Dirte420/zigbee-baseboard/plan/zigbee-baseboard.kicad_pcb

## KiCad design plan/zigbee-baseboard.kicad_pcb (2026-09-25)

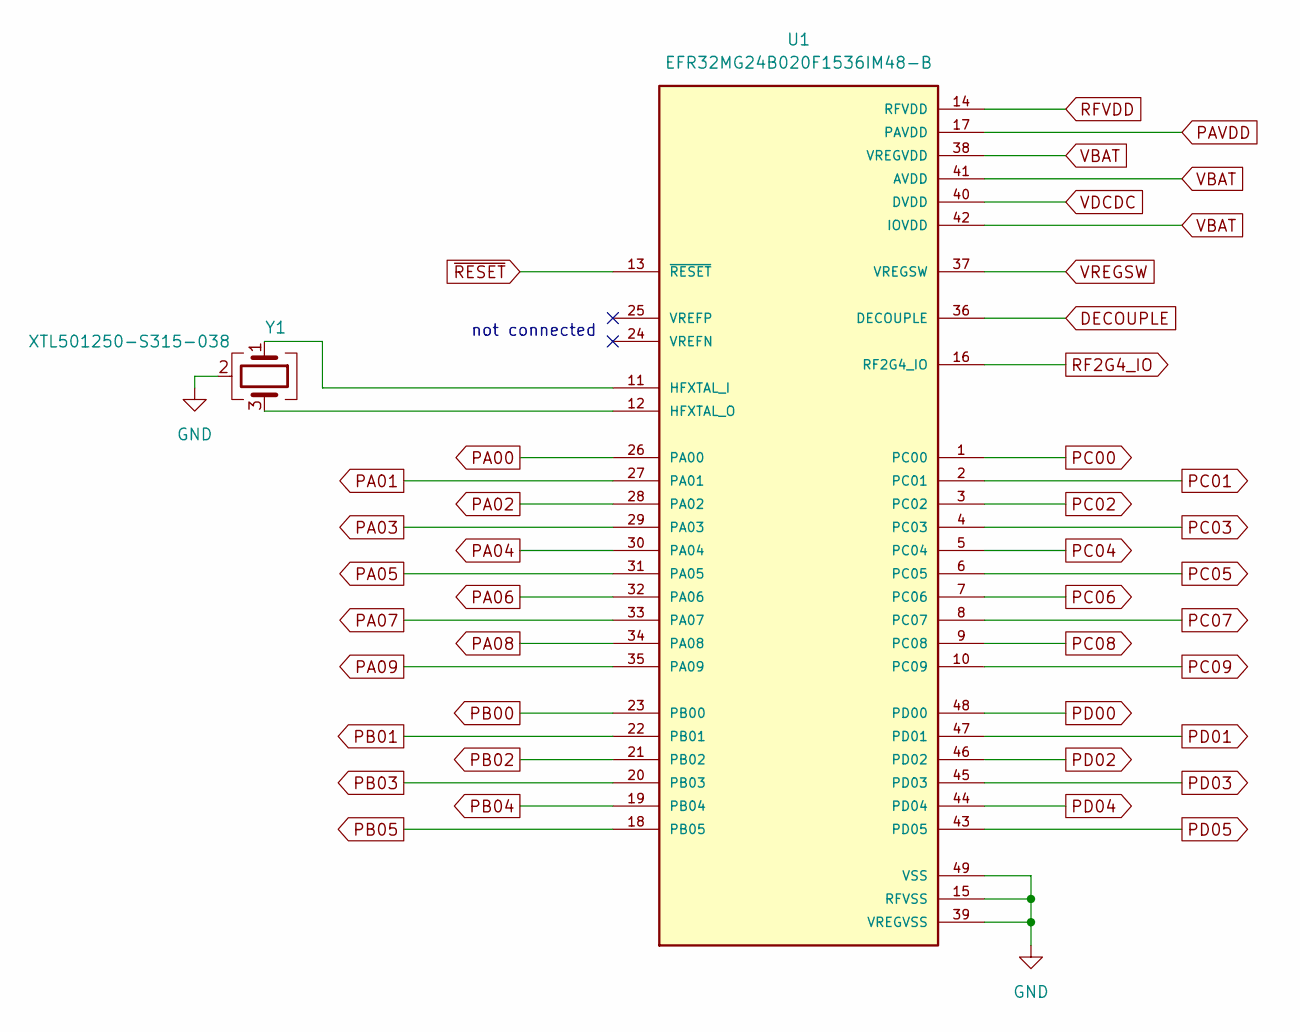
[picture p1: schematic MCU.kicad_sch]

Parts:
U1: EFR32MG24B020F1536IM48-B; QFN-48-1EP_6x6mm_P0.4mm_EFR32MG24
Y1: XTL501250-S315-038; Crystal_Siward_XTL501250_2.0x1.6mm

Connections:
DECOUPLE: U1.36 (DECOUPLE); also elsewhere on the board
GND: U1.15 (RFVSS), U1.39 (VREGVSS), U1.49 (VSS), Y1.2 (G), Y1.4 (G); also elsewhere on the board
unnamed: U1.11 (HFXTAL_I), Y1.1
unnamed: U1.12 (HFXTAL_O), Y1.3
PA00: U1.26 (PA00); also elsewhere on the board
PA01: U1.27 (PA01); also elsewhere on the board
PA02: U1.28 (PA02); also elsewhere on the board
PA03: U1.29 (PA03); also elsewhere on the board
PA04: U1.30 (PA04); also elsewhere on the board
PA05: U1.31 (PA05); also elsewhere on the board
PA06: U1.32 (PA06); also elsewhere on the board
PA07: U1.33 (PA07); also elsewhere on the board
PA08: U1.34 (PA08); also elsewhere on the board
PA09: U1.35 (PA09); also elsewhere on the board
PAVDD: U1.17 (PAVDD); also elsewhere on the board
PB00: U1.23 (PB00); also elsewhere on the board
PB01: U1.22 (PB01); also elsewhere on the board
PB02: U1.21 (PB02); also elsewhere on the board
PB03: U1.20 (PB03); also elsewhere on the board
PB04: U1.19 (PB04); also elsewhere on the board
PB05: U1.18 (PB05); also elsewhere on the board
PC00: U1.1 (PC00); also elsewhere on the board
PC01: U1.2 (PC01); also elsewhere on the board
PC02: U1.3 (PC02); also elsewhere on the board
PC03: U1.4 (PC03); also elsewhere on the board
PC04: U1.5 (PC04); also elsewhere on the board
PC05: U1.6 (PC05); also elsewhere on the board
PC06: U1.7 (PC06); also elsewhere on the board
PC07: U1.8 (PC07); also elsewhere on the board
PC08: U1.9 (PC08); also elsewhere on the board
PC09: U1.10 (PC09); also elsewhere on the board
PD00: U1.48 (PD00); also elsewhere on the board
PD01: U1.47 (PD01); also elsewhere on the board
PD02: U1.46 (PD02); also elsewhere on the board
PD03: U1.45 (PD03); also elsewhere on the board
PD04: U1.44 (PD04); also elsewhere on the board
PD05: U1.43 (PD05); also elsewhere on the board
RF2G4_IO: U1.16 (RF2G4_IO); also elsewhere on the board
RFVDD: U1.14 (RFVDD); also elsewhere on the board
VBAT: U1.38 (VREGVDD), U1.41 (AVDD), U1.42 (IOVDD); also elsewhere on the board
VDCDC: U1.40 (DVDD); also elsewhere on the board
VREGSW: U1.37 (VREGSW); also elsewhere on the board
~RESET: U1.13 (~RESET); also elsewhere on the board

Notes on the sheet:
not connected

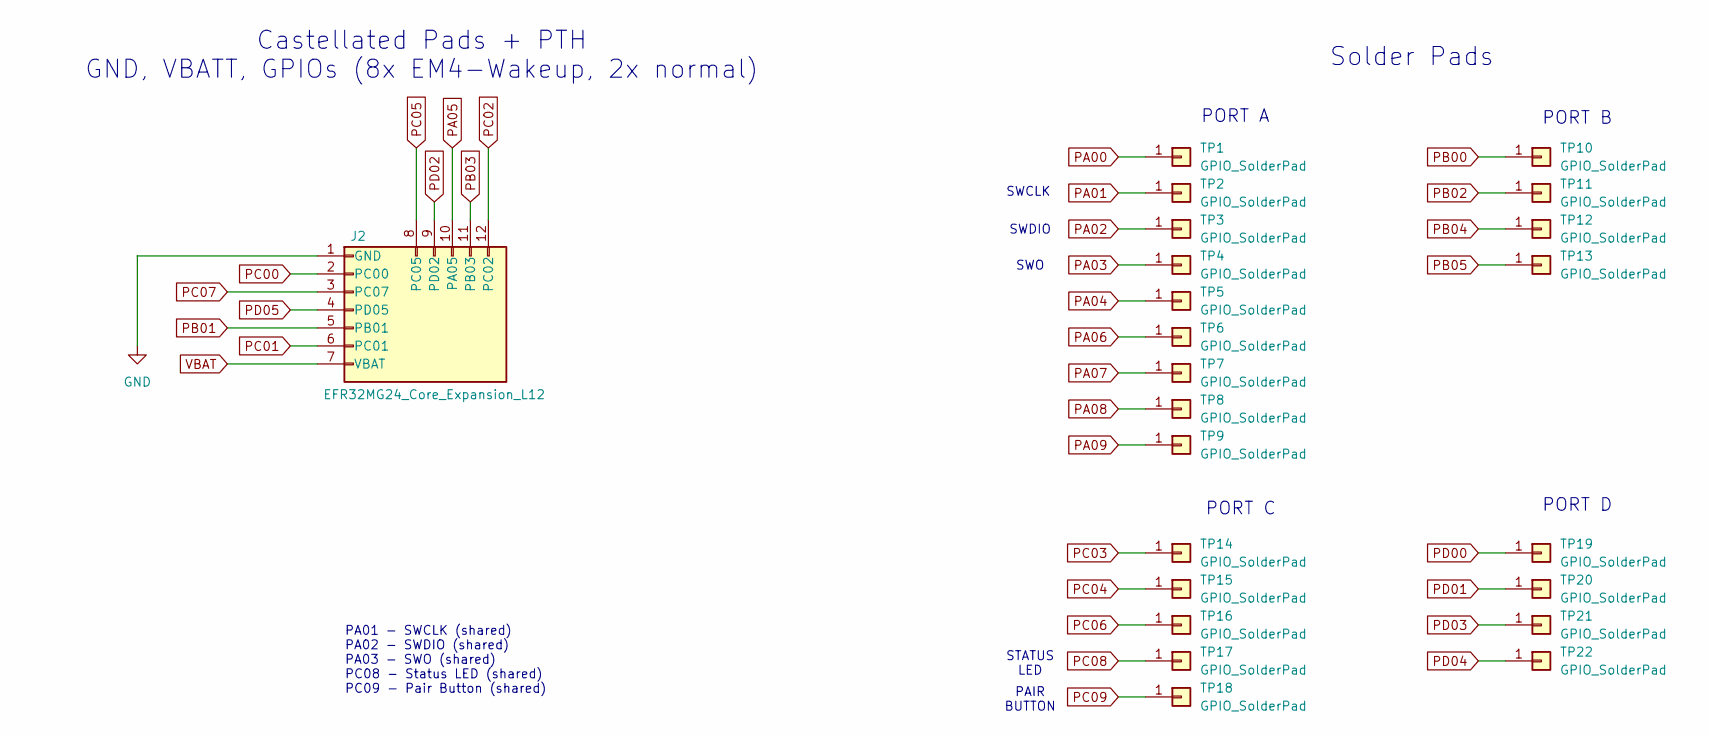
[picture p2: schematic Expansion.kicad_sch]

Parts:
J2: EFR32MG24_Core_Expansion_L12; Module_EFR32MG24_Core_Castellated_L_12Pin_P2.54mm
TP1, TP2, TP3, TP4, TP5, TP6, TP7, TP8, TP9, TP10, TP11, TP12, TP13, TP14, TP15, TP16, TP17, TP18, TP19, TP20, TP21, TP22: GPIO_SolderPad; GPIO_SolderPad_D1.0mm_Bottom

Connections:
GND: J2.1 (GND); also elsewhere on the board
PA00: TP1.1; also elsewhere on the board
PA01: TP2.1; also elsewhere on the board
PA02: TP3.1; also elsewhere on the board
PA03: TP4.1; also elsewhere on the board
PA04: TP5.1; also elsewhere on the board
PA05: J2.10 (PA05); also elsewhere on the board
PA06: TP6.1; also elsewhere on the board
PA07: TP7.1; also elsewhere on the board
PA08: TP8.1; also elsewhere on the board
PA09: TP9.1; also elsewhere on the board
PB00: TP10.1; also elsewhere on the board
PB01: J2.5 (PB01); also elsewhere on the board
PB02: TP11.1; also elsewhere on the board
PB03: J2.11 (PB03); also elsewhere on the board
PB04: TP12.1; also elsewhere on the board
PB05: TP13.1; also elsewhere on the board
PC00: J2.2 (PC00); also elsewhere on the board
PC01: J2.6 (PC01); also elsewhere on the board
PC02: J2.12 (PC02); also elsewhere on the board
PC03: TP14.1; also elsewhere on the board
PC04: TP15.1; also elsewhere on the board
PC05: J2.8 (PC05); also elsewhere on the board
PC06: TP16.1; also elsewhere on the board
PC07: J2.3 (PC07); also elsewhere on the board
PC08: TP17.1; also elsewhere on the board
PC09: TP18.1; also elsewhere on the board
PD00: TP19.1; also elsewhere on the board
PD01: TP20.1; also elsewhere on the board
PD02: J2.9 (PD02); also elsewhere on the board
PD03: TP21.1; also elsewhere on the board
PD04: TP22.1; also elsewhere on the board
PD05: J2.4 (PD05); also elsewhere on the board
VBAT: J2.7 (VBAT); also elsewhere on the board

Notes on the sheet:
PA01 - SWCLK (shared) PA02 - SWDIO (shared) PA03 - SWO (shared) PC08 - Status LED (shared) PC09 - Pair Button (shared)
PORT C
Castellated Pads + PTH GND, VBATT, GPIOs (8x EM4-Wakeup, 2x normal)
SWCLK
SWDIO
PORT B
PAIR BUTTON
PORT D
STATUS LED
Solder Pads
SWO
PORT A

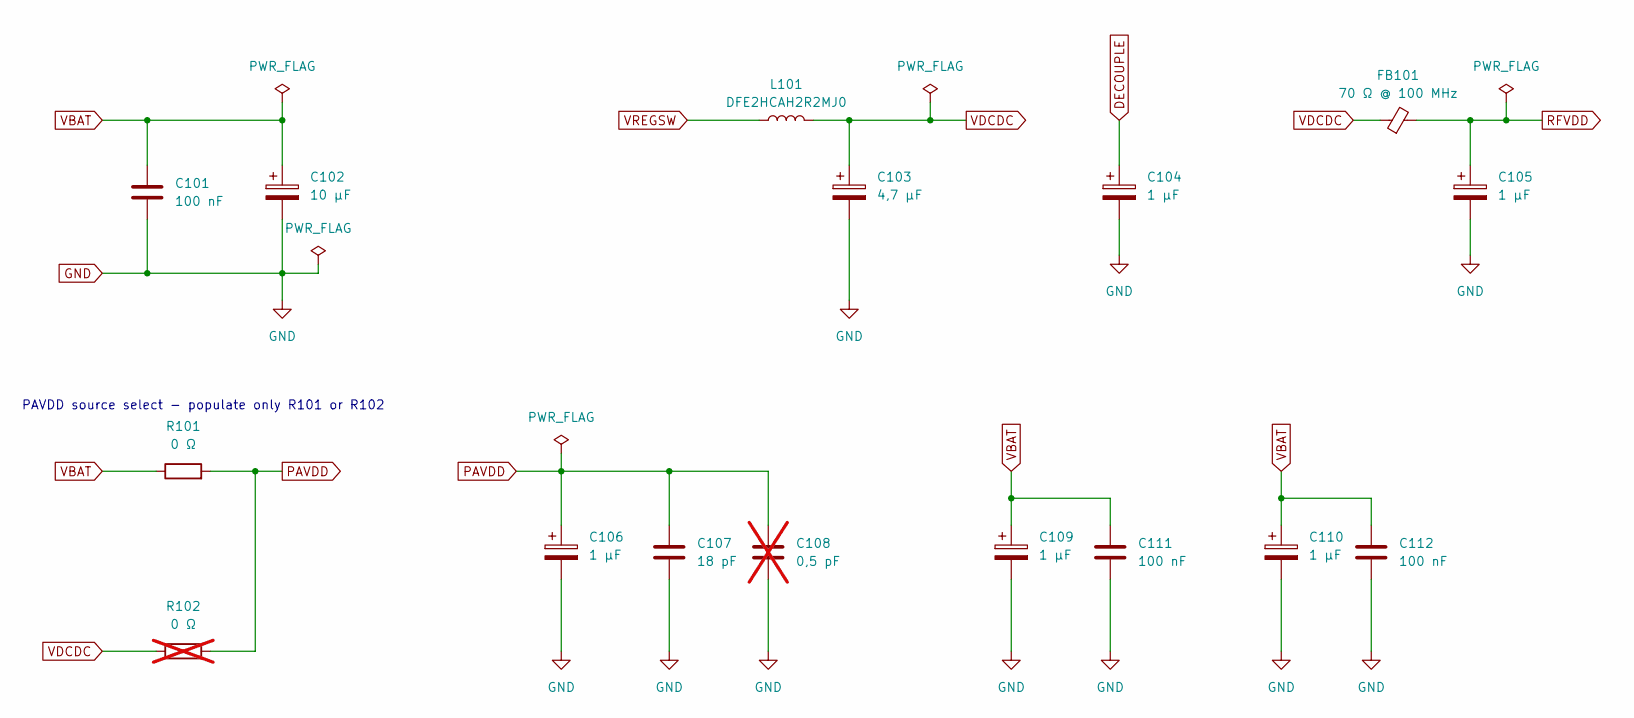
[picture p3: schematic Power.kicad_sch]

Parts:
C101, C111, C112: 100 nF; C_0402_1005Metric
C102: 10 µF; C_0603_1608Metric
C103: 4,7 µF; C_0603_1608Metric
C104, C105, C106, C109, C110: 1 µF; C_0402_1005Metric
C107: 18 pF; C_0201_0603Metric
C108: 0,5 pF; C_0201_0603Metric; not fitted
FB101: 70 Ω @ 100 MHz; L_0201_0603Metric
L101: DFE2HCAH2R2MJ0; Inductor_Murata_DFE2HCAH_2520; MPN DFE2HCAH2R2MJ0
R101: 0 Ω; R_0402_1005Metric
R102: 0 Ω; R_0402_1005Metric; not fitted

Connections:
DECOUPLE: C104.1; also elsewhere on the board
GND: C101.2, C102.2, C103.2, C104.2, C105.2, C106.2, C107.2, C108.2, C109.2, C110.2, C111.2, C112.2; also elsewhere on the board
PAVDD: C106.1, C107.1, C108.1, R101.2, R102.2; also elsewhere on the board
RFVDD: C105.1, FB101.2; also elsewhere on the board
VBAT: C101.1, C102.1, C109.1, C110.1, C111.1, C112.1, R101.1; also elsewhere on the board
VDCDC: C103.1, FB101.1, L101.2, R102.1; also elsewhere on the board
VREGSW: L101.1; also elsewhere on the board

Notes on the sheet:
PAVDD source select - populate only R101 or R102

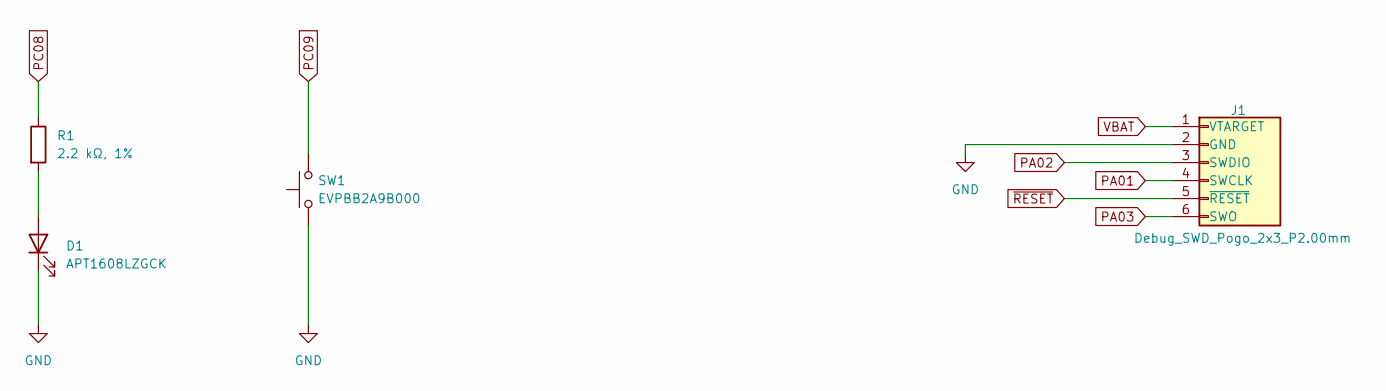
[picture p4: schematic UserDebug.kicad_sch]

Parts:
D1: APT1608LZGCK; LED_0603_1608Metric
J1: Debug_SWD_Pogo_2x3_P2.00mm
R1: 2.2 kΩ, 1%; R_0402_1005Metric
SW1: EVPBB2A9B000; Button_Panasonic_EVPBB_2.6x1.6mm

Connections:
GND: D1.1 (K), J1.2 (GND), SW1.1; also elsewhere on the board
unnamed: D1.2 (A), R1.2
PA01: J1.4 (SWCLK); also elsewhere on the board
PA02: J1.3 (SWDIO); also elsewhere on the board
PA03: J1.6 (SWO); also elsewhere on the board
PC08: R1.1; also elsewhere on the board
PC09: SW1.2; also elsewhere on the board
VBAT: J1.1 (VTARGET); also elsewhere on the board
~RESET: J1.5 (~RESET); also elsewhere on the board

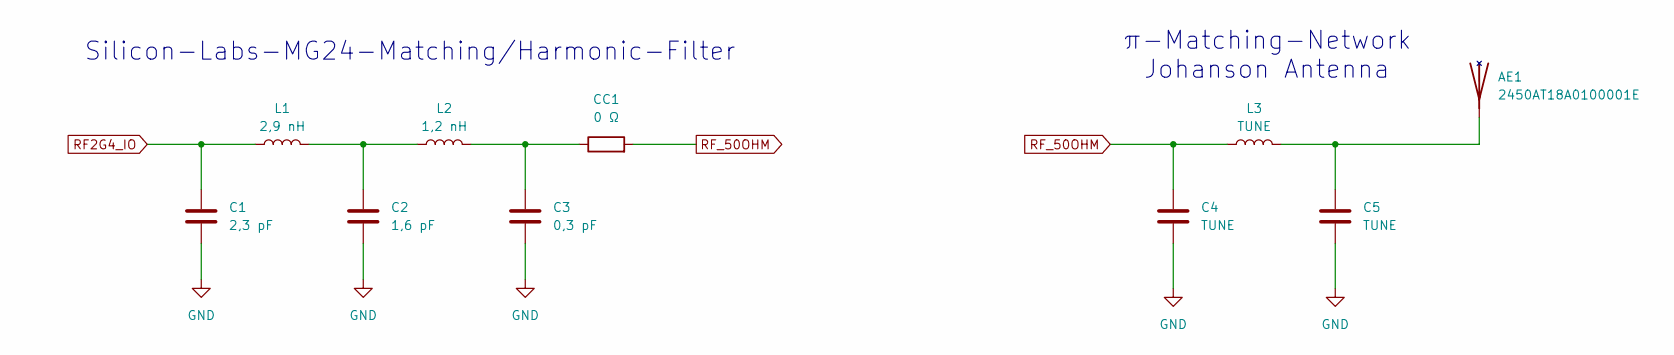
[picture p5: schematic RF.kicad_sch]

Parts:
AE1: 2450AT18A0100001E; Antenna_Johanson_2450AT18A0100001E
C1: 2,3 pF; C_0201_0603Metric
C2: 1,6 pF; C_0201_0603Metric
C3: 0,3 pF; C_0201_0603Metric
C4, C5: TUNE; C_0201_0603Metric
CC1: 0 Ω; R_0201_0603Metric
L1: 2,9 nH; L_0201_0603Metric
L2: 1,2 nH; L_0201_0603Metric
L3: TUNE; L_0201_0603Metric

Connections:
GND: C1.2, C2.2, C3.2, C4.2, C5.2; also elsewhere on the board
unnamed: AE1.1 (FEED_1), C5.1, L3.2
unnamed: C2.1, L1.2, L2.1
unnamed: C3.1, CC1.1, L2.2
RF2G4_IO: C1.1, L1.1; also elsewhere on the board
RF_50OHM: C4.1, CC1.2, L3.1

Notes on the sheet:
π-Matching-Network Johanson Antenna
Silicon-Labs-MG24-Matching/Harmonic-Filter

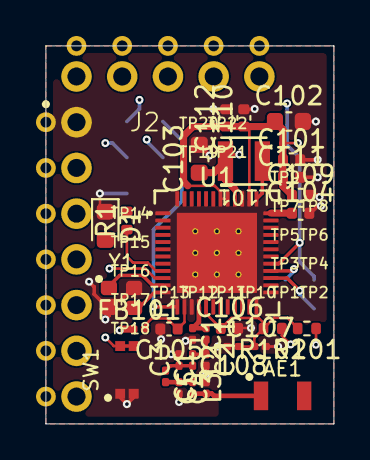
[picture p6: board zigbee-baseboard.kicad_pcb from above]

Board: 4 copper layers, 16.0 x 21.0 mm, 55 parts (0 on the bottom side), 48 nets.
