Dirte420/zigbee-baseboard/(commit log)

2026-09-18 Create basic structure of schematic
    [Expansion.kicad_sch, MCU.kicad_sch, Power.kicad_sch, RF.kicad_sch, UserDebug.kicad_sch, zigbee-baseboard.kicad_sch]
2026-09-18 Move KiCad project to subdirectory /plan
    [Expansion.kicad_sch, MCU.kicad_sch, Power.kicad_sch, RF.kicad_sch, UserDebug.kicad_sch, zigbee-baseboard.kicad_pcb, zigbee-baseboard.kicad_sch]
2026-09-21 Create power schematic according to datasheet of MG24 and reference design
    [Power.kicad_sch]
2026-09-21 Create MCU schematic according to datasheet of MG24 and reference design
    [MCU.kicad_sch]
2026-09-22 Create UserDebug schematic
    - Status LED
    - Pair Button
    - Pogo Pin Adapter Pad (for programming)
    [UserDebug.kicad_sch]
2026-09-22 Create Expansion schematic
    Expansion for GPIOs on
    - Castellated Pads
    - Solder Pins
    [Expansion.kicad_sch]
2026-09-22 Added information about shared GPIOs
    [Expansion.kicad_sch]
2026-09-22 Assign footprints to devices on power schematic
    [Power.kicad_sch, RF.kicad_sch]
2026-09-22 Adapt schematics to pass ERC
    - Clean AVDD / IOVDD / VREGVDD: use VBAT instead
    - Clean DVDD / VDCDC: remove net DVDD and use VDCDC instead
    - Use original symbol from library for J1
    - Mark VBAT / VDCDC / RFVDD / PAVDD / GND with PWR_FLAG
    [MCU.kicad_sch, Power.kicad_sch, UserDebug.kicad_sch]
2026-09-22 Definition of 4-layer physical stackup
    [zigbee-baseboard.kicad_pcb]
2026-09-22 Refine stackup according to impedance calculation
    Use JLCPCB impedance calculator to define the correct stackup and trace-width for 50ohm net
    - configure trace width for net RF_50OHM to 0.2631 mm
    - adapt 4-layer physical stackup according to calculation result
    [zigbee-baseboard.kicad_pcb]
2026-09-22 Initially update board from schematic
    [zigbee-baseboard.kicad_pcb]
2026-09-22 First raw placement of RF-Block
    - RF-Matching-Network
    - Antenna-Tuning-Network
    [zigbee-baseboard.kicad_pcb]
2026-09-22 First raw placement of Power-Section
    [zigbee-baseboard.kicad_pcb]
2026-09-23 Place antenna
    [zigbee-baseboard.kicad_pcb]
2026-09-23 Place keepout-zone for antenna area
    [zigbee-baseboard.kicad_pcb]
2026-09-23 Adapt antenna keepout area and device placement
    - Increase board size at the lower right edge for better placement
    - Avoid GND pads inside of keepout area
    - Move C2 and C106 out of antenna area
    [zigbee-baseboard.kicad_pcb]
2026-09-23 Place GND vias for antenna tuning
    - place small GND vias next to GND pads of antenna tuning devices (C4, C5)
    - adapt position so that GND vias can get placed perfectly with minimum track length
    [zigbee-baseboard.kicad_pcb]
2026-09-23 Add custom design rule to allow clearance of 0,1mm next to U1
    This rule is necessary for being able to rout any tracks from U1
2026-09-23 Route MG24 Matching network
    [zigbee-baseboard.kicad_pcb]
2026-09-23 Route complete RF path
    [zigbee-baseboard.kicad_pcb]
2026-09-23 Adjust and place Castellated Pads and THT connection
    This implicitly defines the edge cuts of the board
    [Expansion.kicad_sch, zigbee-baseboard.kicad_pcb]
2026-09-23 Lock devices which are critical according to their placement
    - RF path
    - MG24
    - Antenna
    - Castellated Pads / THT
    [zigbee-baseboard.kicad_pcb]
2026-09-23 Adapt and place programming/debug pad
    - Remove NPTH holes because they require too much space
    - Place pad on board bottom side
    [UserDebug.kicad_sch, zigbee-baseboard.kicad_pcb]
2026-09-23 Place pairing-button
    [zigbee-baseboard.kicad_pcb]
2026-09-23 Place status LED
    [zigbee-baseboard.kicad_pcb]
2026-09-23 Basic placement of GPIO pads on bottom side
    [zigbee-baseboard.kicad_pcb]
2026-09-23 Adapt GND vias according to clearance errors of DRC
    [zigbee-baseboard.kicad_pcb]
2026-09-23 Adapt custom design rules to accept clearance of 0,18mm on the same footprint
    General clearance of 0,20mm stays
2026-09-23 Change board setup for via size
    - minimum via diameter: 0.35mm
    - minimum via hole: 0.20mm
2026-09-24 Adapt board size
    The castellated pads currently doesn't really fit on the board.
    The clearance to the lower board edge is not enough.
    Therefore the board size has to get increased minimal to a size of 16x21mm
    [zigbee-baseboard.kicad_pcb]
2026-09-24 Place castellated pads on board edge
    After adapting the board edges, place the castellated pads again on the board edge.
    [zigbee-baseboard.kicad_pcb]
2026-09-24 Place GND area on F.Cu and In1.Cu
    [zigbee-baseboard.kicad_pcb]
2026-09-24 Change priority of existing rules
    The more on top the less priority the rules have.
    The rule "U1 QFN clearance" has higher priority than "Same footprint pad clearance"
2026-09-24 Change minimum track width to 0,15mm
    This is necessary to route any track from MG24 chip
2026-09-24 Route power lines
    [zigbee-baseboard.kicad_pcb]
2026-09-24 Exclude castellated pads from DRC clearance violations
    An exception with comment should be set because the castellated pads must be placed centered to the board edge so that they will get cut later.
2026-09-25 Rout crystal and pogo pins
    [zigbee-baseboard.kicad_pcb]
2026-09-25 Route pairing button and LED
    [zigbee-baseboard.kicad_pcb]
